yong-pii/Spark-T12/README.md

# Spark-T12

2023/03/02：
更新了V1.21版本 经过两周左右的使用体验，使用情况基本稳定，欢迎小伙伴们迭代以及自行下载制作~

2023/03/02：
对烙铁头与PCB的连接处理进行了说明，提供了连接弹片的购买链接。

2023/03/13：
更正NTC电阻的型号：NCP15XH103J03RC （10k）,若选用其他电阻请修改程序NTC.c中的相关参数。

2023/03/15：
在Spark-T12 V1.21/pcb_prj/立创专业版 文件夹中更新了PCB工程，具体内容见其文件夹下的TXT说明文件。
