yong-pii/Spark-T12/Spark-T12 V1.21/pcb_prj/readme.txt

pcb绘制使用的是立创EDA专业版

pcb相关数据及注意事项：

下单的时候板厚选1.0mm,否则外壳可能盖不严

2023/03/02  信电二班小皮同学
