yong-pii/Spark-T12/Spark-T12 V1.21/pcb_prj/立创专业版/readme.txt

说明：V1.21为上传的初始版本
V1.22为更新的版本
V1.22更新内容：
1，重新整理了元器件属性，更新了BOOM。
2，NTC电阻型号替换为程序对应型号。
3，PCB去掉了靠近oled屏幕焊盘的两个测试点，防止短路。
