yong-pii/Spark-T12/Spark-T12 V1.21/code_prj/Code/Readme.txt

2023.01.20   01:38:
1,解决了休眠模式下烙铁头失控持续加热的Bug
2,解决了读/写flash时，导致单片机重启或者PWM外设失效的问题
3,优化了休眠模式与正常模式的切换逻辑

0208：
IIC_communication_busy
OLED通信未改

02/09：
彻底修复了休眠期间烧烙铁头的BUG

待优化任务：
界面切换
温度校准（重新采集数据，生成拟合多项式）

0219
PWM不输出

0221:
P 在300~400区间为15
400+为18

0222:
ntc测温正常，下一步增加PCB过温保护策略

2023/03/02
格式，注释整理，优化。
