yong-pii/Spark-T12/Spark-T12 V1.21/code_prj/readme.txt

keilC51 工程  代码文件

硬件已经集成了TTL转串口，通过type-c接口复位（短接R23）mcu下载程序

2023/03/02  信电二班小皮同学
