yong-pii/Spark-T12/Spark-T12 V1.1/Code/2023-0120_T12/Code-V1.11/Readme.txt

2023.01.20   01:38:
1,解决了休眠模式下烙铁头失控持续加热的Bug
2,解决了读/写flash时，导致单片机重启或者PWM外设失效的问题
3,优化了休眠模式与正常模式的切换逻辑
