yong-pii/Spark-T12/Spark-T12 V1.21/pcb_prj/立创专业版/V1.22/BOM_Board1_Schematic1_2023-03-15.xlsx

Quantity | Comment | Designator | Footprint | Value | Manufacturer Part | Manufacturer | Supplier Part | Supplier | Description | No. | Type
1 | BEEP | BP1 | BUZ-SMD_3P-L5.2-W5.2-P3.50-BR | 4000Hz | Cy-SMD-5020-3040 | CY(超音) | C968743 | LCSC | 5x5x2mm | 1
3 | 1uF | C1,C11,C22 | C0402 | 1uF | CL05A105KA5NQNC | SAMSUNG(三星) | C52923 | LCSC | 容值:1uF;精度:±10%;额定电压:25V;材质(温度系数):X5R; | 2
3 | 4.7uF | C2,C12,C15 | C0402 | 4.7uF | CL05A475MP5NRNC | SAMSUNG(三星) | C23733 | LCSC | 容值:4.7uF;精度:±20%;额定电压:10V;材质(温度系数):X5R; | 3
14 | 100nF | C3,C6,C7,C8,C10,C13,C16,C17,C18,C20,C21,C23,C24,C25 | C0402 | 100nF | CL05B104KB54PNC | SAMSUNG(三星) | C307331 | LCSC | 容值:100nF;精度:±10%;额定电压:50V;材质(温度系数):X7R; | 4
4 | 22uF | C4,C26,C27,C30 | C0805 | 22uF | CL21A226MAYNNNE | SAMSUNG(三星) | C602037 | LCSC | 容值:22uF;精度:±20%;额定电压:25V;材质(温度系数):X5R; | 5
2 | 47uF | C5,C29 | CASE-A_3216 | 47uF | TAJA476K006RNJ | Kyocera AVX | C7190 | LCSC | 容值:47uF;精度:±10%;额定电压:6.3V;等效串联电阻:1.6Ω@100kHz;工作温度:-55℃~+125℃; | 6
2 | 10uF | C9,C19 | C0402 | 10uF | CL05A106MQ5NUNC | SAMSUNG(三星) | C15525 | LCSC | 容值:10uF;精度:±20%;额定电压:6.3V;材质(温度系数):X5R; | 7
1 | 2.2uF | C14 | C0402 | 2.2uF | CL05A225MQ5NSNC | SAMSUNG(三星) | C12530 | LCSC | 容值:2.2uF;精度:±20%;额定电压:6.3V;材质(温度系数):X5R; | 8
1 | 1N4148 | D1 | SOD-523_L1.2-W0.8-LS1.6-RD |  | 1N4148WT | SMC(桑德斯) | C493211 | LCSC | 二极管配置:独立式;功率:150mW;直流反向耐压(Vr):75V;平均整流电流(Io):150mA;正向压降(Vf):1.25V@150mA;反向电流(Ir):1A@75V;反向恢复时间(trr):4ns;工作温度:+150@(Tj); | 9
1 | 1N4148WT | D3 | SOD-523_L1.2-W0.8-LS1.6-RD |  | 1N4148WT | TECH PUBLIC(台舟) | C708767 | LCSC | 二极管配置:独立式;功率:200mW;直流反向耐压(Vr):75V;平均整流电流(Io):150mA;正向压降(Vf):1V@10mA;反向电流(Ir):5uA@75V;反向恢复时间(trr):4ns; | 10
1 | BZX584C2V4/BZX584C3V3 | D4 | SOD-523F_L1.2-W0.8-LS1.7-RD |  | BZX584C2V4-V-G-08 | VISHAY | C73412 | LCSC |  | 11
1 | 1N5819WS | D5 | SOD-323_L1.8-W1.3-LS2.5-RD |  | 1N5819WS | Hottech(合科泰) | C191023 | LCSC | 直流反向耐压(Vr):40V;平均整流电流(Io):1A;正向压降(Vf):600mV@1A; | 12
1 |  | LED1 | LED0603-RD_BLUE |  |  |  | C72044 |  | 发光颜色:红灯;二极管配置:-;透镜颜色:无色透明;主波长:617.5nm;峰值波长:632nm;色温:-;光通量(25时):-;测试电流:5mA;正向电压(VF):2.2V;发光强度:28.5mcd;功率:60mW;发光角度:120°;安装方式:-;工作温度:-40~+85; | 13
1 | SE30P12D | Q1 | DFN-8_L3.0-W3.0-P0.65-BL |  | SE30P12D | SINO-IC(光宇睿芯) | C238703 | LCSC | 类型:P沟道;漏源电压(Vdss):30V;连续漏极电流(Id):12A;功率(Pd):2W;导通电阻(RDS(on)@Vgs,Id):15mΩ@10V,10A;阈值电压(Vgs(th)@Id):3V@250uA; | 14 | P沟道
2 | S8050 J3Y | Q2,Q3 | SOT-23_L2.9-W1.3-P1.90-LS2.4-BR |  | S8050 J3Y | CJ(江苏长电/长晶) | C2146 | LCSC | 晶体管类型:NPN;集射极击穿电压(Vceo):25V;集电极电流(Ic):500mA;功率(Pd):300mW;集电极截止电流(Icbo):100nA;集电极-发射极饱和电压(VCE(sat)@Ic,Ib):600mV@500mA,50mA;直流电流增益(hFE@Ic,Vce):200@50mA,1V;特征频率(fT):150MHz;工作温度:+150℃@(Tj); | 15
1 | AO3401A | Q4 | SOT-23_L2.9-W1.3-P1.90-LS2.4-BR |  | AO3401A | AOS | C15127 | LCSC | 类型:P沟道;漏源电压(Vdss):30V;连续漏极电流(Id):4A;功率(Pd):1.4W;导通电阻(RDS(on)@Vgs,Id):44mΩ@10V,4.3A;阈值电压(Vgs(th)@Id):1.3V@250uA; | 16 | P沟道
2 | 0402WGF5101TCE | R1,R2 | R0402 | 5.1K | 0402WGF5101TCE | UNI-ROYAL(厚声) | C25905 | LCSC |  | 17
1 | 100kΩ | R3 | R0402 | 100kΩ | 0402WGF1003TCE | UNI-ROYAL(厚声) | C25741 | LCSC | 电阻类型:厚膜电阻;阻值:100kΩ;精度:±1%;功率:62.5mW;温度系数:±100ppm/℃;最大工作电压:50V;工作温度范围:-55℃~+155℃; | 18 | 厚膜电阻
1 | 4.7kΩ | R6 | R0402 | 4.7kΩ | 0402WGF4701TCE | UNI-ROYAL(厚声) | C25900 | LCSC | 功率:1/16W;精度:±1%;阻值:4.7kΩ;温度系数:±100ppm/℃;最大工作电压:50V;工作温度范围:-55℃~+155℃; | 19
3 | 1kΩ | R7,R8,R20 | R0402 | 1kΩ | 0402WGF1001TCE | UNI-ROYAL(厚声) | C11702 | LCSC | 电阻类型:厚膜电阻;阻值:1kΩ;精度:±1%;功率:62.5mW;温度系数:±100ppm/℃;最大工作电压:50V;工作温度范围:-55℃~+155℃; | 20 | 厚膜电阻
1 | 560kΩ | R9 | R0402 | 560kΩ | ERJ2RKD5603X | PANASONIC(松下) | C416446 | LCSC | 阻值:560kΩ;精度:±0.5%;功率:63mW;温度系数:±100ppm/℃;最大工作电压:100V;工作温度范围:-55℃~+155℃; | 21
1 | 0603WAF4701T5E | R10 | R0603 | 4.7K | 0603WAF4701T5E | UNI-ROYAL(厚声) | C23162 | LCSC |  | 22
9 | 10kΩ | R11,R12,R13,R14,R15,R16,R17,R19,R24 | R0402 | 10kΩ | 0402WGF1002TCE | UNI-ROYAL(厚声) | C25744 | LCSC | 电阻类型:厚膜电阻;阻值:10kΩ;精度:±1%;功率:62.5mW;温度系数:±100ppm/℃;最大工作电压:50V;工作温度范围:-55℃~+155℃; | 23 | 厚膜电阻
1 | NCP15XH103J03RC | R18 | R0402 |  | NCP15XH103J03RC | muRata(村田) | C96633 | LCSC | 阻值(25℃):10kΩ;电阻精度:±5%;B值精度:±1%;B值(25℃/50℃):3380K;功率:100mW;最大稳态电流(25℃):310uA;B值(25℃/75℃):-;B值(25℃/85℃):3434K;B值(25℃/100℃):3455K;工作温度:-40℃~+125℃; | 24
1 | NC | R21 | R0402 | NC |  |  |  |  | NC | 25
1 | NC | R23 | R0603 | NC |  |  |  |  |  | 26
1 | 0402WGF1000TCE | R25 | R0402 | 100Ω | 0402WGF1000TCE | UNI-ROYAL(厚声) | C25076 | LCSC |  | 27
3 | TS3315A | SW1,SW2,SW3 | SW-SMD_4P-L3.4-W3.4-P2.00-LS4.0_TS3315A160GF |  | TS3315A | SHOU HAN(首韩) | C412367 | LCSC | 触点电流:50mA;额定电压(AC):-;额定电压(DC):12V;额定功率:-;绝缘电阻:-;电路结构:单刀单掷;安装方式:立贴;按钮形状:圆形按钮;按钮/盖帽颜色:-;带灯:-;作用力:5N;机械寿命:-;工作温度:-;防护等级:-;引脚样式:-;开关长度:3.3mm;开关宽度:3.3mm;开关高度:1.5mm;带支架:-; | 28
1 | N091-2832TSWFG02-H14 | U2 | SSD1306-14PIN_0.91_JX |  | N091-2832TSWFG02-H14 | Allvision(全智景) | C2890599 | LCSC | 尺寸(inch):0.91;主控芯片:SSD1306; | 29
1 | LM321MFX | U3 | SOT-23-5_L2.9-W1.6-P0.95-LS2.8-BL |  | LM321MFX | TECH PUBLIC(台舟) | C3011196 | LCSC |  | 30
1 | CH224D | U5 | QFN20_3X3 |  |  |  |  |  | USB PD & Type-C & Fast Charge Power Consumer Controller | 31
1 | CH340E | U7 | MSOP-10_L3.0-W3.0-P0.50-LS5.0-BL |  | CH340E | WCH(南京沁恒) | C99652 | LCSC | 类型:Transceiver;协议类别:USB 2.0;驱动器/接收器数:-;数据速率:2Mbps; | 32 | Transceiver
1 | STC8H1K17-36I-QFN20 | U9 | QFN-20_L3.0-W3.0-P0.40-BL-EP1.7 |  | STC8H1K17-36I-QFN20 | STC(宏晶) | C915676 | LCSC | CPU内核:51系列;CPU最大主频:-;工作电压范围:1.9V~5.5V;内部振荡器:有;外部时钟频率范围:4MHz~33MHz;程序 FLASH容量:17KB;RAM总容量:1.25KB;EEPROM/数据 FLASH容量:-;GPIO端口数量:17;ADC(单元数/通道数/位数):1@x9ch/10bit;DAC(单元数/通道数/位数):-;(E)PWM(单元数/通道数/位数):2@x4ch/16bit;8位Timer数量:-;16位Timer数量:3;32位Timer数量:-;内部比较器数量:1; | 33
1 | SC7A20TR | U10 | LGA-12_L2.0-W2.0-P0.50-BL |  | SC7A20TR | SILAN(士兰微) | C5126709 | LCSC |  | 34
1 | HE2021A33HPR | U11 | SOT-89-3_L4.5-W2.5-P1.50-LS4.2-BR |  | HE2021A33HPR | HEERMICR(赫尔半导体) | C711942 | LCSC | 输出类型:固定;输出极性:正;输出通道数:1;最大输入电压:35V;输出电压:3.3V;压差:400mV;静态电流(地电流):2uA;输出电流:200mA;电源纹波抑制比(PSRR):60dB@1kHz; | 35
1 | KH-TYPE-C-16P | USB1 | USB-C-SMD_KH-TYPE-C-16P |  | KH-TYPE-C-16P | kinghelm(金航标) | C709357 | LCSC | 连接器类型:Type-C;标准:-;公母:母座;触点数量:16;端口数量:1;安装方式:卧贴;额定电流 - 电源:3A;工作温度范围:-40~+85; | 36
