yong-pii/Spark-T12/Spark-T12 V1.1/3D Model/3D Printf/Shell 1.stl

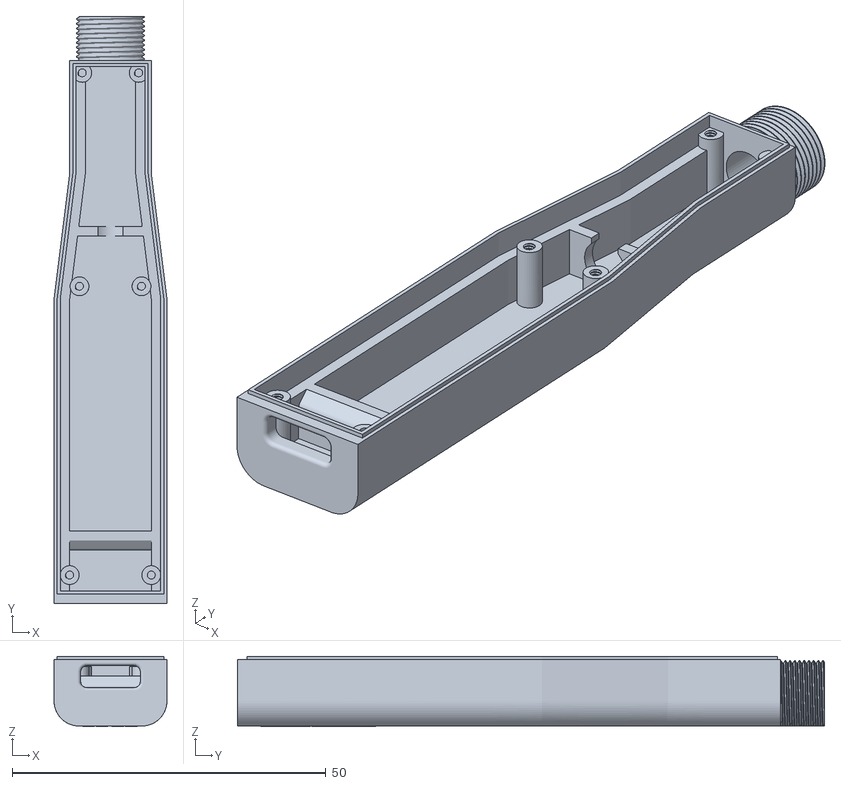
[picture p1: CAD file, 2023-01-01, an earlier design]
Spark-T12 V1.1/3D Model/3D Printf/Shell 1.stl
18.0 x 93.6 x 11.2
