yong-pii/Spark-T12/Spark-T12 V1.1/3D Model/3D Printf/Shell 2.stl

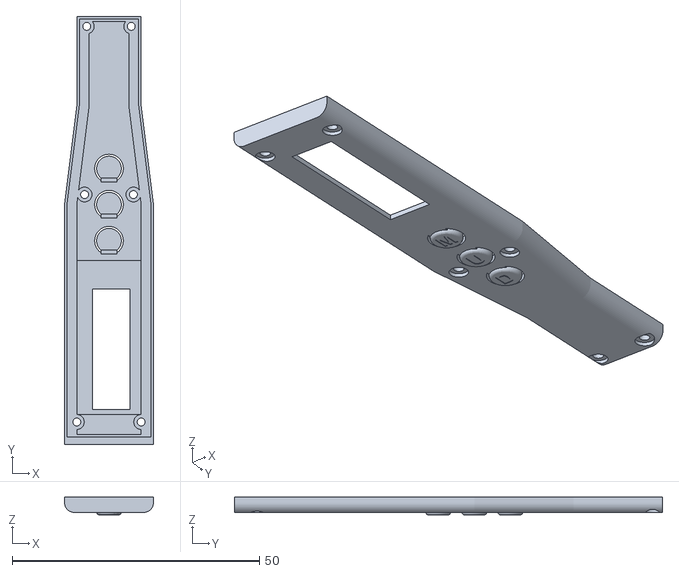
[picture p2: CAD file, 2023-01-01, an earlier design]
Spark-T12 V1.1/3D Model/3D Printf/Shell 2.stl
18.0 x 86.6 x 3.60
