yong-pii/Spark-T12/(list of files, cad)

Other CAD files:
Spark-T12 V1.1/Code/1230_T12/Code-v1.1/list/main.obj
Spark-T12 V1.1/Code/1230_T12/Code-v1.1/list/EEPROM.obj
Spark-T12 V1.1/Code/1230_T12/Code-v1.1/list/ADC.obj
Spark-T12 V1.1/Code/1230_T12/Code-v1.1/list/oled.obj
Spark-T12 V1.1/Code/1230_T12/Code-v1.1/list/PWM.obj
Spark-T12 V1.1/Code/1230_T12/Code-v1.1/list/Interface.obj
Spark-T12 V1.1/Code/1230_T12/Code-v1.1/list/key.obj
Spark-T12 V1.1/Code/1230_T12/Code-v1.1/list/Spark_T12_PID.obj
Spark-T12 V1.1/Code/1230_T12/Code-v1.1/list/timer.obj
Spark-T12 V1.1/Code/1230_T12/Code-v1.1/list/delay.obj
Spark-T12 V1.1/Code/1230_T12/Code-v1.1/list/beep.obj
Spark-T12 V1.1/Code/1230_T12/Code-v1.1/list/Ch224d.obj
Spark-T12 V1.1/Code/1230_T12/Code-v1.1/list/UART.obj
Spark-T12 V1.1/Code/1230_T12/Code-v1.1/list/sleep.obj
Spark-T12 V1.1/Code/1230_T12/Code-v1.1/list/GPIO.obj
