yong-pii/Spark-T12/(threads)

Thread 2 (2023-04-07):

Firmware update

yong-pii, 2023-04-07:
更新了程序固件

更新内容：
优化了界面显示，降低了数据刷新速度。
增加了一键休眠功能，主界面下长按M键进入休眠模式。
缩短了开机化锡时间，现约8s左右。

烧录前注意事项（重要！！！）：
因为flash会被重置，烧录前务必记好自己设备的温度偏移量，烧录成功后自行恢复该偏移量！！！

烧录步骤：
1,电脑下载安装CH340驱动，下载STC-isp
2,拆开电烙铁，取出PCB，将PCB通过type-C线与电脑连接。
3，打开STC-isp，此时软件应识别到CH340。
4，设置单片机型号为STC81K17,主频设置为30MHz
5，选择此次升级的固件（V2-2304.HEX，文件已压缩)
6，点击下载，然后使用镊子短路背面焊盘中较大的两个（一共两组空焊盘，选大的那组），此时软件提示开始下载
7，下载完成后不要忘记恢复偏移量~

说明：自行设计有有一定概率因为自行操作不当导致烙铁发生故障，此类后果自负呦~（一定要小心，不要让烙铁或者其他东西短路PCB上的其他任何东西！）
[V2-2304.zip](https://github.com/yong-pii/Spark-T12/files/11179550/V2-2304.zip)

yong-pii, 2023-04-07:
修正一下，单片机型号为STC8H1K17

yong-pii, 2023-04-07:
注意，短接的焊盘是贴片焊盘，不是通孔
