yong-pii/Spark-T12/Spark-T12 V1.1/PCB Prj/SCH_Schematic1_2022-12-31.pdf

# type-c母座

# MCU

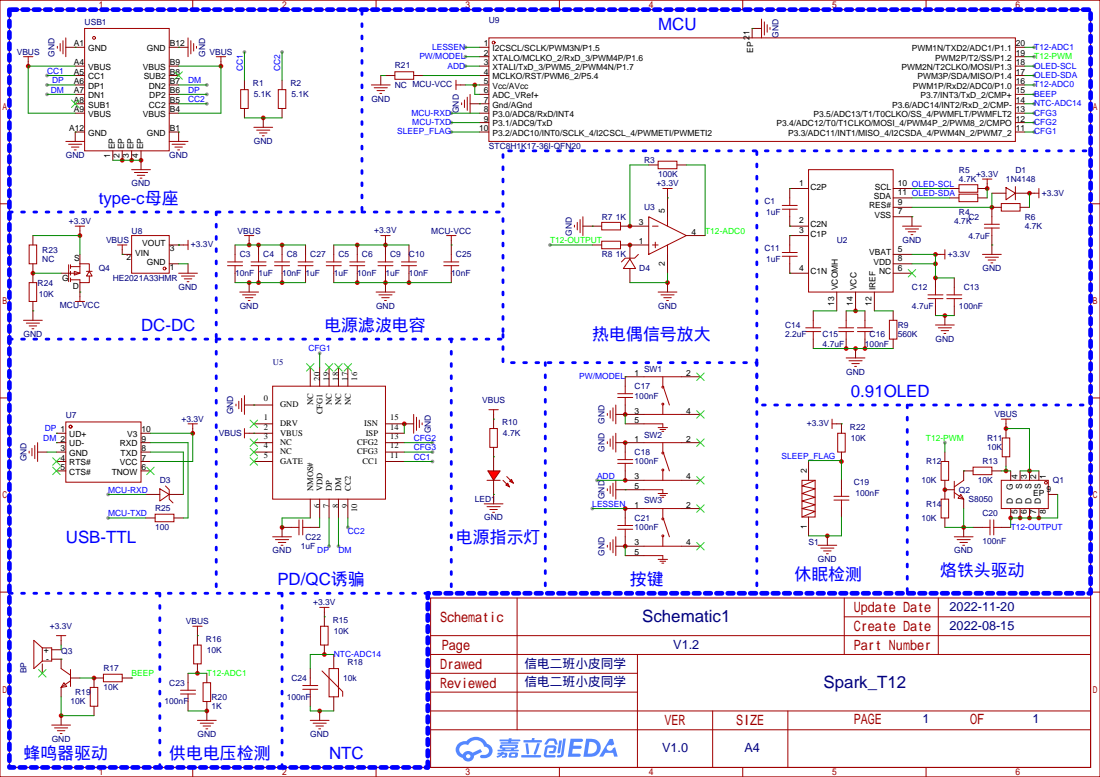
[picture p3: page 1]
