yong-pii/Spark-T12/Spark-T12 V1.21/pcb_prj/立创专业版/V1.21/SCH_Schematic1_2023-03-02.pdf

type-c母座 | 电源指示灯

# MCU

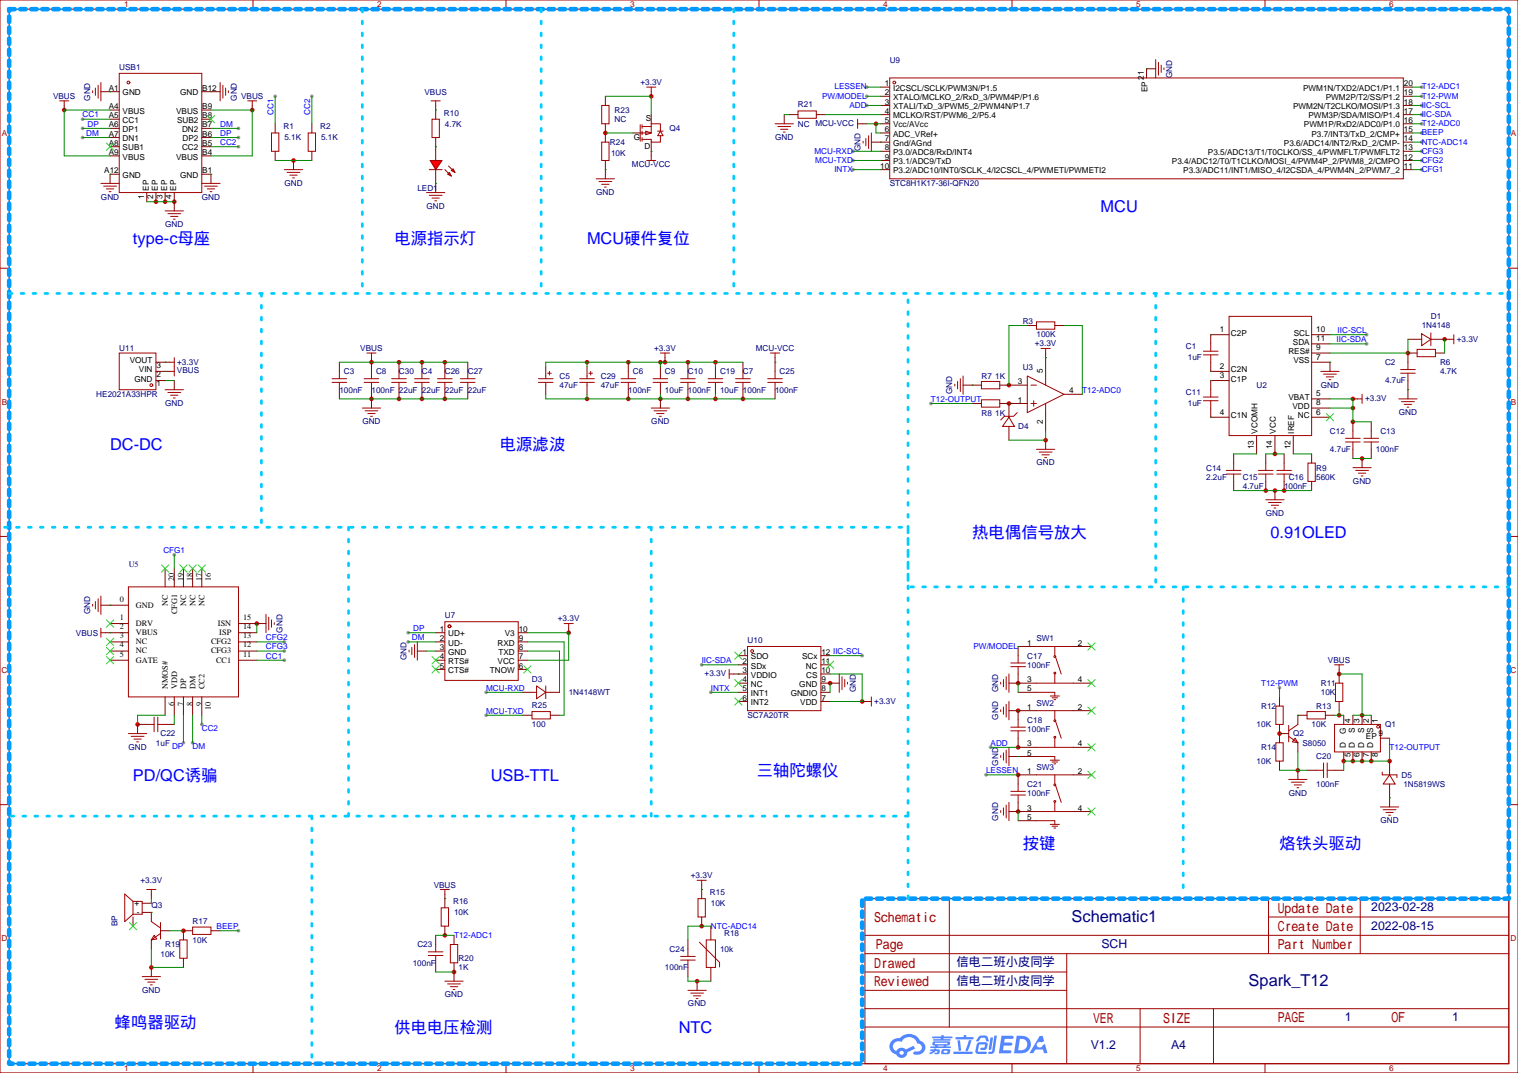
[picture p4: page 1]

Page | SCH | Part Number
Drawed | 信电二班小皮同学
Reviewed | 信电二班小皮同学
