yong-pii/Spark-T12/Spark-T12 V1.21/code_prj/Code/SRC/oledfont.h

#ifndef __OLEDFONT_H
#define __OLEDFONT_H 	   

/************************************6*8的点阵************************************/
unsigned char code asc2_0806[][6] ={
{0x00, 0x00, 0x00, 0x00, 0x00, 0x00},// sp
{0x00, 0x00, 0x00, 0x2f, 0x00, 0x00},// !
{0x00, 0x00, 0x07, 0x00, 0x07, 0x00},// "
{0x00, 0x14, 0x7f, 0x14, 0x7f, 0x14},// #
{0x00, 0x24, 0x2a, 0x7f, 0x2a, 0x12},// $
{0x00, 0x62, 0x64, 0x08, 0x13, 0x23},// %
{0x00, 0x36, 0x49, 0x55, 0x22, 0x50},// &
{0x00, 0x00, 0x05, 0x03, 0x00, 0x00},// '
{0x00, 0x00, 0x1c, 0x22, 0x41, 0x00},// (
{0x00, 0x00, 0x41, 0x22, 0x1c, 0x00},// )
{0x00, 0x14, 0x08, 0x3E, 0x08, 0x14},// *
{0x00, 0x08, 0x08, 0x3E, 0x08, 0x08},// +
{0x00, 0x00, 0x00, 0xA0, 0x60, 0x00},// ,
{0x00, 0x08, 0x08, 0x08, 0x08, 0x08},// -
{0x00, 0x00, 0x60, 0x60, 0x00, 0x00},// .
{0x00, 0x20, 0x10, 0x08, 0x04, 0x02},// /
{0x00, 0x3E, 0x51, 0x49, 0x45, 0x3E},// 0
{0x00, 0x00, 0x42, 0x7F, 0x40, 0x00},// 1
{0x00, 0x42, 0x61, 0x51, 0x49, 0x46},// 2
{0x00, 0x21, 0x41, 0x45, 0x4B, 0x31},// 3
{0x00, 0x18, 0x14, 0x12, 0x7F, 0x10},// 4
{0x00, 0x27, 0x45, 0x45, 0x45, 0x39},// 5
{0x00, 0x3C, 0x4A, 0x49, 0x49, 0x30},// 6
{0x00, 0x01, 0x71, 0x09, 0x05, 0x03},// 7
{0x00, 0x36, 0x49, 0x49, 0x49, 0x36},// 8
{0x00, 0x06, 0x49, 0x49, 0x29, 0x1E},// 9
{0x00, 0x00, 0x36, 0x36, 0x00, 0x00},// :
{0x00, 0x00, 0x56, 0x36, 0x00, 0x00},// ;
{0x00, 0x08, 0x14, 0x22, 0x41, 0x00},// <
{0x00, 0x14, 0x14, 0x14, 0x14, 0x14},// =
{0x00, 0x00, 0x41, 0x22, 0x14, 0x08},// >
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
/* (12 X 12 , 宋体 )*/

{0x00,0xFE,0x02,0x42,0x42,0x42,0xFA,0x42,0x42,0x42,0x02,0x00,0x08,0x07,0x08,0x08,0x08,0x08,0x0F,0x08,0x09,0x0A,0x08,0x00},/*"压",18*/
/* (12 X 12 , 宋体 )*/

// 温(0) 度(1) 偏(2) 移(3) 校(4) 准(5)

{0x22,0x44,0x00,0xC0,0x5F,0xD5,0x55,0xD5,0x5F,0xC0,0x00,0x00,0x04,0x02,0x09,0x0F,0x08,0x0F,0x08,0x0F,0x08,0x0F,0x08,0x00},/*"温",19*/
/* (12 X 12 , 宋体 )*/

{0x00,0xFE,0x0A,0x8A,0xBE,0xAA,0xAB,0xAA,0xBE,0x8A,0x0A,0x00,0x08,0x07,0x00,0x08,0x09,0x0A,0x04,0x04,0x0A,0x09,0x08,0x00},/*"度",20*/
/* (12 X 12 , 宋体 )*/

{0x10,0xFC,0x03,0x80,0xFE,0x2A,0xEA,0x2B,0xEA,0x2A,0xEE,0x00,0x00,0x0F,0x01,0x00,0x0F,0x01,0x07,0x01,0x07,0x09,0x0F,0x00},/*"偏",21*/
/* (12 X 12 , 宋体 )*/

{0x12,0xD2,0xFE,0x91,0x08,0x44,0xAB,0x52,0x6A,0x46,0xC0,0x00,0x01,0x00,0x0F,0x00,0x08,0x09,0x04,0x05,0x02,0x01,0x00,0x00},/*"移",22*/
/* (12 X 12 , 宋体 )*/

{0x88,0x68,0xFF,0x28,0x44,0x24,0xD5,0x06,0xD4,0x24,0x44,0x00,0x00,0x00,0x0F,0x00,0x08,0x08,0x05,0x02,0x05,0x08,0x08,0x00},/*"校",23*/
/* (12 X 12 , 宋体 )*/

{0x04,0x08,0x20,0x10,0xFC,0x27,0x24,0xFD,0x26,0x24,0x04,0x00,0x04,0x02,0x01,0x00,0x0F,0x09,0x09,0x0F,0x09,0x09,0x08,0x00},/*"准",24*/
/* (12 X 12 , 宋体 )*/

};

#endif
