yong-pii/Spark-T12/Spark-T12 V1.21/code_prj/Code/STClibrary/EEPROM.c

/*---------------------------------------------------------------------*/
/* --- STC MCU Limited ------------------------------------------------*/
/* --- STC 1T Series MCU Demo Programme -------------------------------*/
/* --- Mobile: (86)13922805190 ----------------------------------------*/
/* --- Fax: 86-0513-55012956,55012947,55012969 ------------------------*/
/* --- Tel: 86-0513-55012928,55012929,55012966 ------------------------*/
/* --- Web: www.STCMCU.com --------------------------------------------*/
/* --- Web: www.STCMCUDATA.com  ---------------------------------------*/
/* --- QQ:  800003751 -------------------------------------------------*/
/* 如果要在程序中使用此代码,请在程序中注明使用了STC的资料及程序            */
/*---------------------------------------------------------------------*/

/***************	功能说明	****************

本文件为STC8系列的内置EEPROM读写程序,用户几乎可以不修改这个程序.

******************************************/

#include "config.h"
#include "eeprom.h"


u16 Start_addrs = 0x0000;
u8  xdata  eeprom_dat[10];  //power / tpme_skewing / temp/10 /sleep_time




//========================================================================
// 函数: void	ISP_Disable(void)
// 描述: 禁止访问ISP/IAP.
// 参数: non.
// 返回: non.
// 版本: V1.0, 2012-10-22
//========================================================================
void	DisableEEPROM(void)
{
    IAP_CONTR = 0;			//禁止IAP操作
    IAP_CMD   = 0;			//去除IAP命令
    IAP_TRIG  = 0;			//防止IAP命令误触发
    IAP_ADDRH = 0xff;		//清0地址高字节
    IAP_ADDRL = 0xff;		//清0地址低字节，指向非EEPROM区，防止误操作
}

//========================================================================
// 函数: void EEPROM_Trig(void)
// 描述: 触发EEPROM操作.
// 参数: none.
// 返回: none.
// 版本: V1.0, 2014-6-30
//========================================================================
void EEPROM_Trig(void)
{
    F0 = EA;    //保存全局中断
    EA = 0;     //禁止中断, 避免触发命令无效
    IAP_TRIG = 0x5A;
    IAP_TRIG = 0xA5;                    //先送5AH，再送A5H到IAP触发寄存器，每次都需要如此
    //送完A5H后，IAP命令立即被触发启动
    //CPU等待IAP完成后，才会继续执行程序。
    _nop_();
    _nop_();
    EA = F0;    //恢复全局中断
}

//========================================================================
// 函数: void EEPROM_read_n(u16 EE_address,u8 *DataAddress,u16 number)
// 描述: 从指定EEPROM首地址读出n个字节放指定的缓冲.
// 参数: EE_address:  读出EEPROM的首地址.
//       DataAddress: 读出数据放缓冲的首地址.
//       number:      读出的字节长度.
// 返回: non.
// 版本: V1.0, 2012-10-22
//========================================================================
void EEPROM_read_n(u16 EE_address, u8 *DataAddress, u16 number)
{
    IAP_ENABLE();                           //设置等待时间，允许IAP操作，送一次就够
    IAP_READ();                             //送字节读命令，命令不需改变时，不需重新送命令
    do
    {
        IAP_ADDRH = EE_address / 256;       //送地址高字节（地址需要改变时才需重新送地址）
        IAP_ADDRL = EE_address % 256;       //送地址低字节
        EEPROM_Trig();                      //触发EEPROM操作
        *DataAddress = IAP_DATA;            //读出的数据送往
        EE_address++;
        DataAddress++;
    }
    while(--number);

    DisableEEPROM();
}

//========================================================================
// 函数: void EEPROM_SectorErase(u16 EE_address)
// 描述: 把指定地址的EEPROM扇区擦除.
// 参数: EE_address:  要擦除的扇区EEPROM的地址.
// 返回: non.
// 版本: V1.0, 2013-5-10
//========================================================================
void EEPROM_SectorErase(u16 EE_address)
{
    IAP_ENABLE();                       //设置等待时间，允许IAP操作，送一次就够
    IAP_ERASE();                        //宏调用, 送扇区擦除命令，命令不需改变时，不需重新送命令
    //只有扇区擦除，没有字节擦除，512字节/扇区。
    //扇区中任意一个字节地址都是扇区地址。
    IAP_ADDRH = EE_address / 256;       //送扇区地址高字节（地址需要改变时才需重新送地址）
    IAP_ADDRL = EE_address % 256;       //送扇区地址低字节
    EEPROM_Trig();                      //触发EEPROM操作
    DisableEEPROM();                    //禁止EEPROM操作
}

//========================================================================
// 函数: void EEPROM_write_n(u16 EE_address,u8 *DataAddress,u16 number)
// 描述: 把缓冲的n个字节写入指定首地址的EEPROM.
// 参数: EE_address:  写入EEPROM的首地址.
//       DataAddress: 写入源数据的缓冲的首地址.
//       number:      写入的字节长度.
// 返回: non.
// 版本: V1.0, 2012-10-22
//========================================================================
void EEPROM_write_n(u16 EE_address, u8 *DataAddress, u16 number)
{
    IAP_ENABLE();                       //设置等待时间，允许IAP操作，送一次就够
    IAP_WRITE();                        //宏调用, 送字节写命令
    do
    {
        IAP_ADDRH = EE_address / 256;     //送地址高字节（地址需要改变时才需重新送地址）
        IAP_ADDRL = EE_address % 256;     //送地址低字节
        IAP_DATA  = *DataAddress;         //送数据到IAP_DATA，只有数据改变时才需重新送
        EEPROM_Trig();                    //触发EEPROM操作
        EE_address++;                     //下一个地址
        DataAddress++;                    //下一个数据
    }
    while(--number);                    //直到结束
    DisableEEPROM();
}

/***********************************************************
*@fuction	:write_rom
*@brief		: 通过函数处理，使其可以直接存入16位数据
*@param		:--u16 address：数据存入的地址   u16 Data_Address：需要存入的变量
*@return	:void
*@author	:--xptx
*@date		:2022-11-19
***********************************************************/

void write_rom(u16 address, u16 Data_Address) //16位 数据写入
{
    u8 x[2];
    if(Data_Address != read_rom(address)) //数据发生更改
    {
        x[0] = 0xff & Data_Address;  //留下低8位
        x[1] = Data_Address >> 8;    //留下高8位
        EEPROM_SectorErase(address);   //擦除扇区
        EEPROM_write_n(address, &x, 2); //写入新的数据
    }
}

/***********************************************************
*@fuction	:read_rom
*@brief		:读取EEPROM里面的8位数据
*@param		:--u16 address：数据存放地址
*@return	:返回8位数据
*@author	:--xptx
*@date		:2022-11-20
***********************************************************/

u8 read_rom(u16 address)
{
    u8  xdata   dat[1];        //EEPROM操作缓冲
    EEPROM_read_n(address, dat, 1);
    return (dat[0]); //返回读取的值
}
/***********************************************************
*@fuction	:Eeprom_updata
*@brief		:更新EEPROM的数据
*@param		:start_address  起始地址
*@param		:*dat           写入数据源的缓冲的首地址
*@param		:Num            数据量
*@return	:void
*@author	:--xptx
*@date		:2023-02-25
***********************************************************/

void Eeprom_updata(u16 start_address, u8 *dat, u8 Num)
{
    u8 i, x = 0;
    u8  xdata   r_dat[10];        //EEPROM操作缓冲
    EA = 0;
    EEPROM_read_n(start_address, &r_dat, Num); //读出EEPROM的数据

    for(i = 0; i < Num; i++)
    {
        if(dat[Num] != r_dat[Num])
        {
            x++;
        }
    }
    if(x != 0)
    {
        EEPROM_SectorErase(start_address);  //擦除扇区
        EEPROM_write_n(start_address, dat, Num); //重新写入数据到扇区

        x = 0;
    }
    EA = 1;
}


/***********************************************************
*@fuction	:Eeprom_data_Init
*@brief		:数据初始化，读取EEPROM内的数据
*@param		:start_address  起始地址
*@param		:*dat           写入数据源的缓冲的首地址
*@param		:Num            数据量
*@return	:void
*@author	:--xptx
*@date		:2023-02-25
***********************************************************/

void Eeprom_data_Init(u16 start_address, u8 *dat, u8 Num)
{
    u8 tmp[10]; //临时缓存
    EA = 0;
    EEPROM_read_n(start_address,&tmp, Num); //读出EEPROM的数据

    if(tmp[0] < 5 || tmp[0] > 20) tmp[0] = 5;             // Power
    if(tmp[1] > 80) tmp[1] = 0;            // tpme_skewing
    if(tmp[2] < 20 || tmp[2] > 45) tmp[2] = 30; // temp/10
	
    if(tmp[3] < 5) tmp[3] = 5;             // sleep_time
  	if(tmp[3] > 30) tmp[3] = 15;             // sleep_time

    EEPROM_write_n(start_address, &tmp, Num); //重新写入数据到扇区
    EEPROM_read_n(start_address, dat, Num); //读出EEPROM的数据
	
	
    EA = 1;
}
