yong-pii/Spark-T12/Spark-T12 V1.21/code_prj/Code/SRC/Interface.h

#ifndef		__interface_H
#define		__interface_H

#include	"config.h"

void show_Init(void);
void interface_show(void); 
void show_1(void);
void show_2(void); //电源电压选择界面
void show_3(void); //PID界面
void show_4(void); //sleep界面
void interface_show1_Init(void);
	
#endif
