yong-pii/Spark-T12/Spark-T12 V1.21/code_prj/Code/STClibrary/timer.h

/*---------------------------------------------------------------------*/
/* --- STC MCU Limited ------------------------------------------------*/
/* --- STC 1T Series MCU Demo Programme -------------------------------*/
/* --- Mobile: (86)13922805190 ----------------------------------------*/
/* --- Fax: 86-0513-55012956,55012947,55012969 ------------------------*/
/* --- Tel: 86-0513-55012928,55012929,55012966 ------------------------*/
/* --- Web: www.STCMCU.com --------------------------------------------*/
/* --- Web: www.STCMCUDATA.com  ---------------------------------------*/
/* --- QQ:  800003751 -------------------------------------------------*/
/* 如果要在程序中使用此代码,请在程序中注明使用了STC的资料及程序            */
/*---------------------------------------------------------------------*/

#ifndef	__TIMER_H
#define	__TIMER_H

#include	"config.h"

#define	Timer0						0
#define	Timer1						1
#define	Timer2						2
#define	Timer3						3
#define	Timer4						4

#define	TIM_16BitAutoReload			0
#define	TIM_16Bit					1
#define	TIM_8BitAutoReload			2
#define	TIM_16BitAutoReloadNoMask	3

#define	TIM_CLOCK_1T				0
#define	TIM_CLOCK_12T				1
#define	TIM_CLOCK_Ext				2

typedef struct
{
	u8	TIM_Mode;		//工作模式,  	TIM_16BitAutoReload,TIM_16Bit,TIM_8BitAutoReload,TIM_16BitAutoReloadNoMask
	u8	TIM_Priority;		//优先级设置	Priority_0,Priority_1,Priority_2,Priority_3
	u8	TIM_Interrupt;	//中断允许		ENABLE,DISABLE
	u8	TIM_ClkSource;	//时钟源		TIM_CLOCK_1T,TIM_CLOCK_12T,TIM_CLOCK_Ext
	u8	TIM_ClkOut;		//可编程时钟输出,	ENABLE,DISABLE
	u16	TIM_Value;		//装载初值
	u8	TIM_Run;		//是否运行		ENABLE,DISABLE
} TIM_InitTypeDef;

u8	Timer_Inilize(u8 TIM, TIM_InitTypeDef *TIMx);

#endif
